busycraftsman/ats3b1/README.md

# ats3b1 project

# AT Sprint 3B.1
AT Sprint 3B1. 6 Bands HF CW/Digital Transceiver, designed by kd1jv.

# AT Sprint 3b.1 filter
filter board
