busycraftsman/ats3b1/嘉立创/drill.png

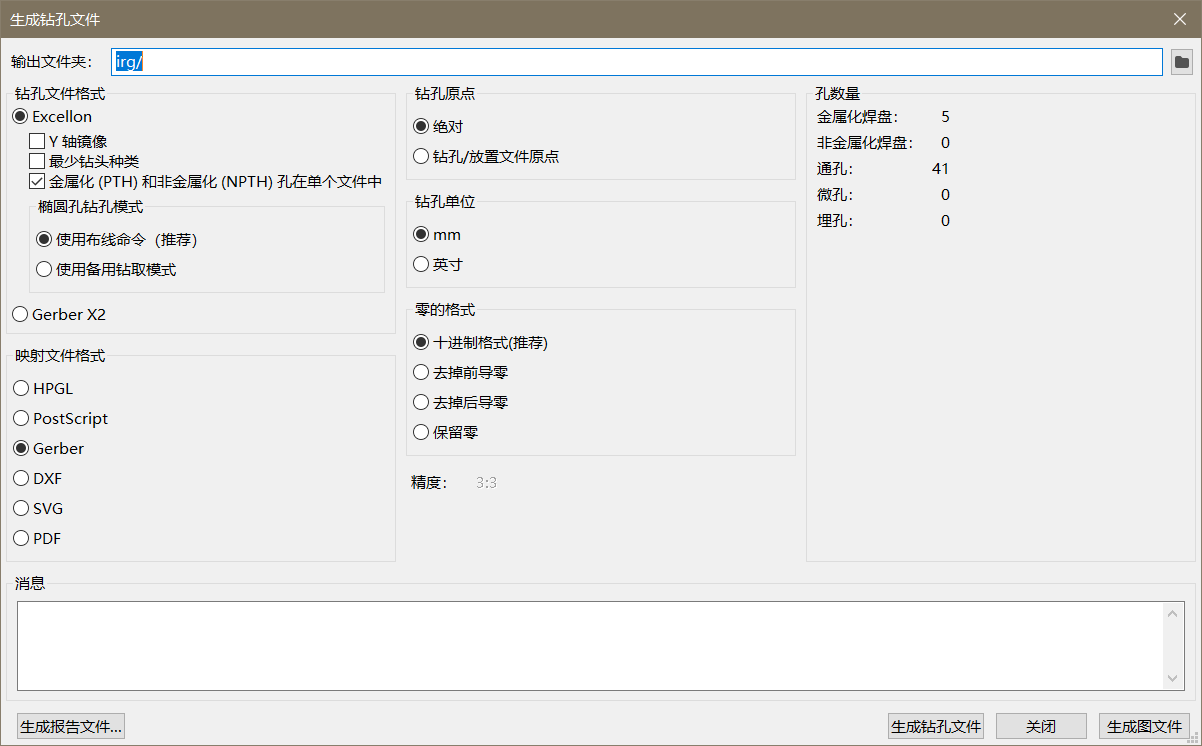
嘉立创/drill.png
