busycraftsman/ats3b1/嘉立创/plot.png

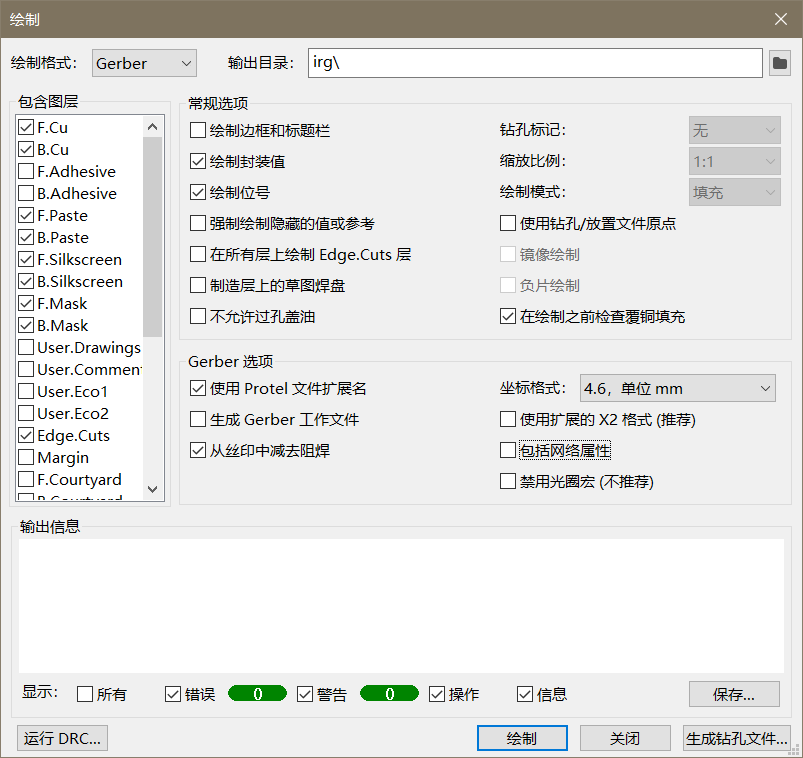
嘉立创/plot.png
