busycraftsman/ats3b1/AT Sprint 3B.1/bom/checklist.xlsx

R1 | 470ohm | C1 | 22p | U1 | SA612A | Q1 | NDT2955 | D1 | SS13(S2) | X1 | 4.9152Mhz |  |  | SW1 | CT1 | 30p | J1
R2 | 10k | C2 | 0.01uF | U2 | SA612A | Q2 | 2N7002 | D2 | BAV99 | X2 | 4.9152Mhz |  |  | SW2
R3 | 330k | C3 | 0.01uF | U3 | LM4808 | Q3 | 2N7002 | D3 | 1N4756 | X3 | 4.9152Mhz | L3 | FT37-43, 13T | SW3
R4 | 10k | C4 | 100p | U4 | CC5R | Q4 | BS170 | D4 | W8 | X4 | 4.9152Mhz |  |  | SW4
R5 | 330k | C5 | 100p | U5 | AC-AN6123MS | Q5 | BS170 |  |  | X5 | 4.9152Mhz
R6 | 22k | C6 | 100p | U6 | M430F1232 | Q6 | BS170 |  |  | X6 | 32.768k | L6 | 10uH
R7 | 22k | C7 | 100p | U7 | AD9834 |  |  |  |  |  |  |  |  |  |  |  |  | Power jack
R8 | 113k | C8 | 100p | U8 | AC02 |  |  |  |  |  |  |  |  |  |  |  |  | SMT phone jacks
R9 | 2.74k | C9 | 0.01uF | U9 | C3E(812C50) |  |  |  |  |  |  |  |  |  |  |  |  | Band module SIP header jack
R10 | 267k | C10 | 0.01uF | U10 | C2P(812C35)
R11 | 100k | C11 | 100p | U11 | MCP120-3151
R12 | 330k | C12 | 100p
R13 | 22k | C13 | 0.001uF
R14 | 100k | C14 | 0.001uF
R15 | 3.6k | C15 | 0.1uF
R16 | 270ohm | C16 | 0.1uF
R17 | 270ohm | C17 | 470p
R18 | 270ohm | C18 | 0.1uF
R19 | 100k | C19 | 0.1uF
R20 | 51ohm | C20 | 0.01uF
R21 | 10k | C21 | 0.01uF
R22 | 2.2k | C22 | 0.01uF
R23 | 10k | C23 | 0.01uF
R24 | 22k | C24 | 0.01uF
R25 | 100k | C25 | 0.1uF
R26 | 13.7k | C26 | 0.01uF
R27 | 47k | C27 | 0.01uF
R28 | 47k | C28 | 22p
R29 | 47k | C29 | 22p
R30 | 47k | C30 | 0.0p
R31 | 47k | C31 | 47p
R32 | 47k | C32 | 0.0p
R33 | 47k | C33 | 22p
R34 | 470ohm | C34 | 100p
R35 | 470ohm | C35 | 0.01uF
R36 | 470ohm | C36 | 0.1uF
R37 | 470ohm | C37 | 0.01uF
R38 | 470ohm | C38 | 0.01uF
R39 | 470ohm | C39 | 0.1uF
R40 | 470ohm | C40 | 0.1uF
R41 | 470ohm | C41 | 0.01uF
R42 | 22k | C42 | 0.01uF
 |  | C43 | 0.01uF
 |  | C44 | 0.01uF
 |  | C45 | 0.01uF
 |  | C46 | 0.1uF
 |  | C47 | 0.1uF
 |  | C48 | 0.01uF
 |  | C49 | 0.001uF
 |  | C50 | 0.01uF
 |  | C51 | 0.01uF
 |  | C52 | 0.1uF
 |  | C53 | 10uF/16V
 |  | C54 | 22uF/16V
 |  | C55 | 10uF/16V
 |  | C56 | 47uF/16V
 |  | C57 | 22uF/16V
 |  | C58 | 100uF, Alum
 |  | C59 | 0.1uF, Mono
