busycraftsman/ats3b1/AT Sprint 3B.1/schematic/board.pdf

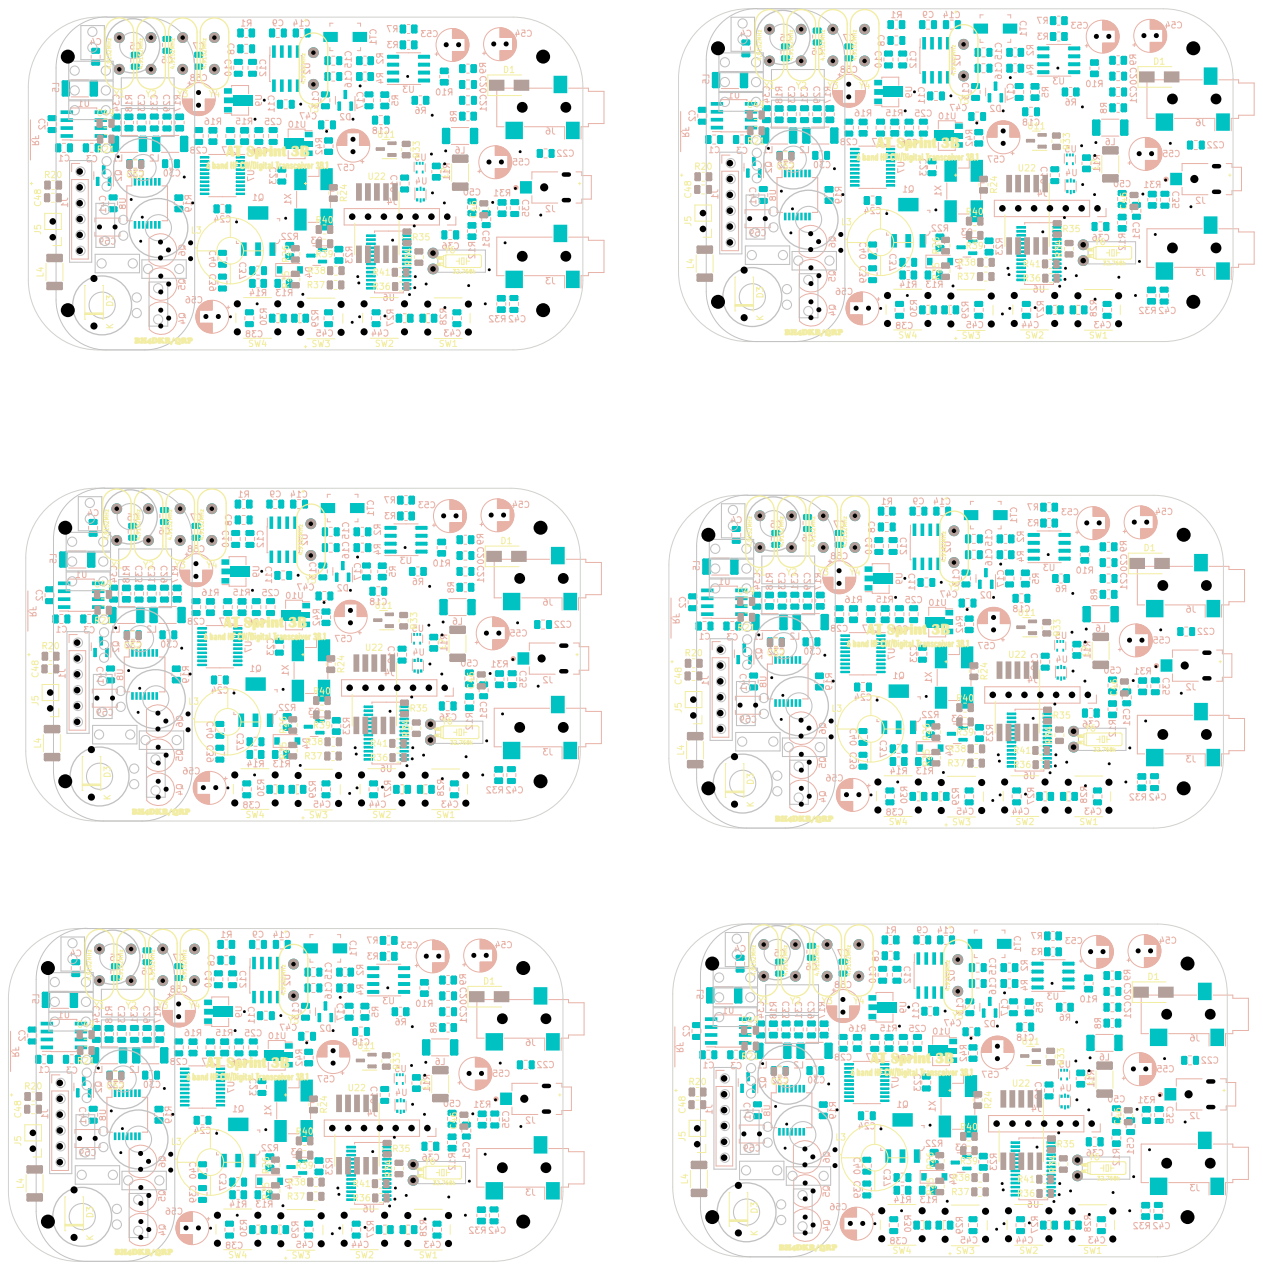
[picture p21: page 1]
