busycraftsman/ats3b1/AT Sprint 3B.1/AT Sprint 3B.1.kicad_pcb

## KiCad design AT Sprint 3B.1/AT Sprint 3B.1.kicad_pcb (2022-05-23)

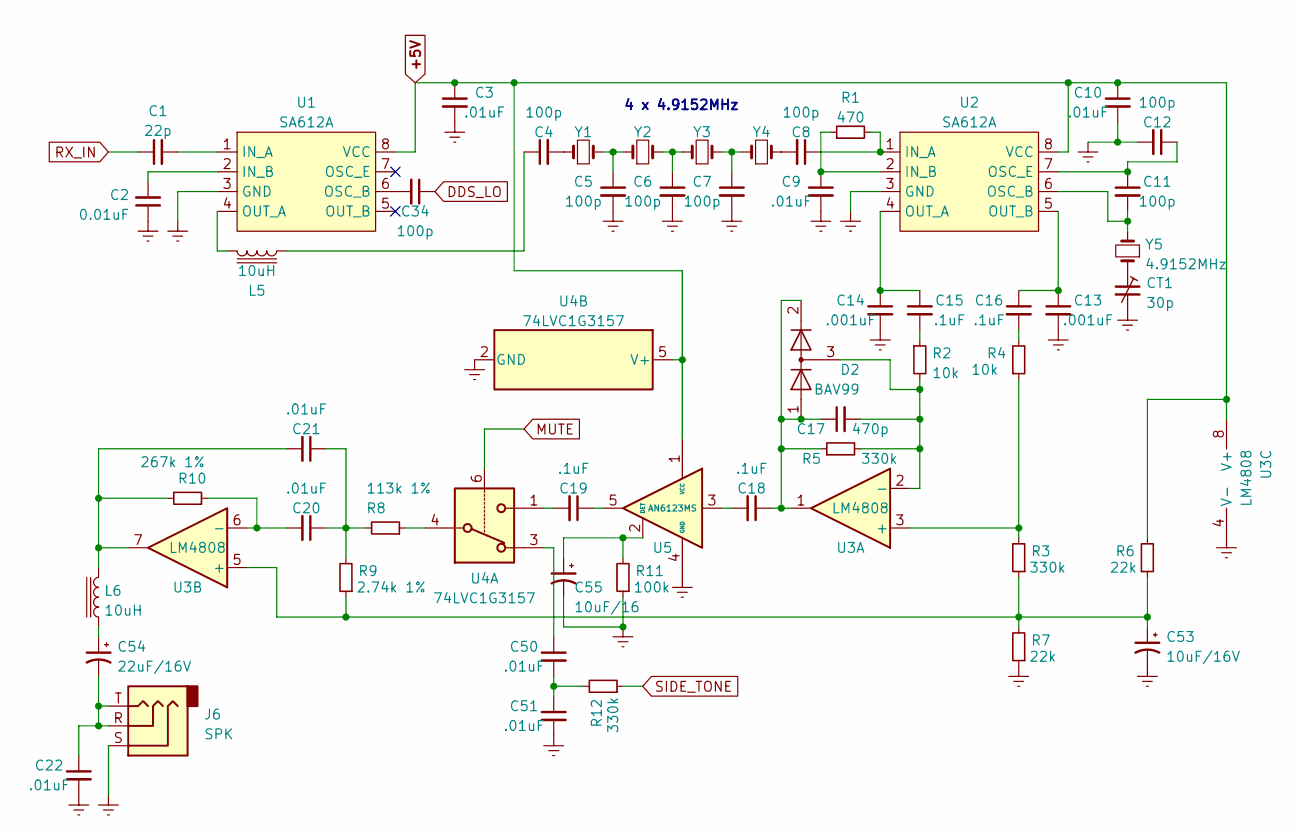
[picture p22: schematic ATS3B1-RECEIVER-AUDIO.kicad_sch]

Parts:
C1: 22p; C_0805_2012Metric
C2: 0.01uF; C_0805_2012Metric
C3, C9, C10, C20, C21, C22, C50, C51: .01uF; C_0805_2012Metric
C4, C5, C6, C7, C8, C11, C12, C34: 100p; C_0805_2012Metric
C13, C14: .001uF; C_0805_2012Metric
C15, C16, C18, C19: .1uF; C_0805_2012Metric
C17: 470p; C_0805_2012Metric
C53: 10uF/16V; CP_Radial_D5.0mm_P2.00mm
C54: 22uF/16V; CP_Radial_D5.0mm_P2.00mm
C55: 10uF/16; CP_Radial_D5.0mm_P2.00mm
CT1: 30p; C_TRIMMER_TZ03
D2: BAV99; SOT-23
J6: SPK; Jack_3.5mm_CUI_SJ-3523-SMT_Horizontal
L5, L6: 10uH; L_2010_5025Metric
R1: 470; R_0805_2012Metric
R2, R4: 10k; R_0805_2012Metric
R3, R5, R12: 330k; R_0805_2012Metric
R6, R7: 22k; R_0805_2012Metric
R8: 113k 1%; R_0805_2012Metric
R9: 2.74k 1%; R_0805_2012Metric
R10: 267k 1%; R_0805_2012Metric
R11: 100k; R_0805_2012Metric
U1, U2: SA612A; PowerIntegrations_SO-8
U3: LM4808; SOIC-8_3.9x4.9mm_P1.27mm
U4: 74LVC1G3157; SOT-666
U5: AN6123MS; SOT-553
Y1, Y2, Y3, Y4, Y5: 4.9152MHz; HC49US

Connections:
+5V: C3.1, C10.1, R6.2, U1.8 (VCC), U2.8 (VCC), U3.8 (V+), U4.5 (V+), U5.1 (VCC); also elsewhere on the board
DDS_LO: C34.1; also elsewhere on the board
GNDREF: C2.1, C3.2, C5.2, C6.2, C7.2, C9.2, C10.2, C12.2, C13.2, C14.2, C22.2, C51.2, C53.2, C55.2, CT1.2, J6.S, R7.1, R11.1, U1.3 (GND), U2.3 (GND), U3.4 (V-), U4.2 (GND), U5.4 (GND); also elsewhere on the board
MUTE: U4.6; also elsewhere on the board
unnamed: C1.2, U1.1 (IN_A)
unnamed: C2.2, U1.2 (IN_B)
unnamed: C4.1, L5.1
unnamed: C4.2, Y1.1
unnamed: C5.1, Y1.2, Y2.1
unnamed: C6.1, Y2.2, Y3.1
unnamed: C7.1, Y3.2, Y4.1
unnamed: C8.1, R1.2, U2.1 (IN_A)
unnamed: C8.2, Y4.2
unnamed: C9.1, R1.1, U2.2 (IN_B)
unnamed: C11.1, C12.1, U2.7 (OSC_E)
unnamed: C11.2, U2.6 (OSC_B), Y5.2
unnamed: C13.1, C16.1, U2.5 (OUT_B)
unnamed: C14.1, C15.1, U2.4 (OUT_A)
unnamed: C15.2, R2.1
unnamed: C16.2, R4.2
unnamed: C17.1, C18.1, D2.1 (K), D2.2 (A), R5.1, U3.1
unnamed: C17.2, D2.3 (K), R2.2, R5.2, U3.2 (-)
unnamed: C18.2, U5.3
unnamed: C19.1, U5.5
unnamed: C19.2, U4.1
unnamed: C20.1, C21.1, R8.2, R9.2
unnamed: C20.2, R10.1, U3.6 (-)
unnamed: C21.2, L6.2, R10.2, U3.7
unnamed: C22.1, C54.2, J6.R, J6.T
unnamed: C34.2, U1.6 (OSC_B)
unnamed: C50.1, U4.3
unnamed: C50.2, C51.1, R12.2
unnamed: C53.1, R3.1, R6.1, R7.2, R9.1, U3.5 (+)
unnamed: C54.1, L6.1
unnamed: C55.1, R11.2, U5.2 (DET)
unnamed: CT1.1, Y5.1
unnamed: L5.2, U1.4 (OUT_A)
unnamed: R3.2, R4.1, U3.3 (+)
unnamed: R8.1, U4.4
RX_IN: C1.1; also elsewhere on the board
SIDE_TONE: R12.1; also elsewhere on the board

Notes on the sheet:
4 x 4.9152MHz

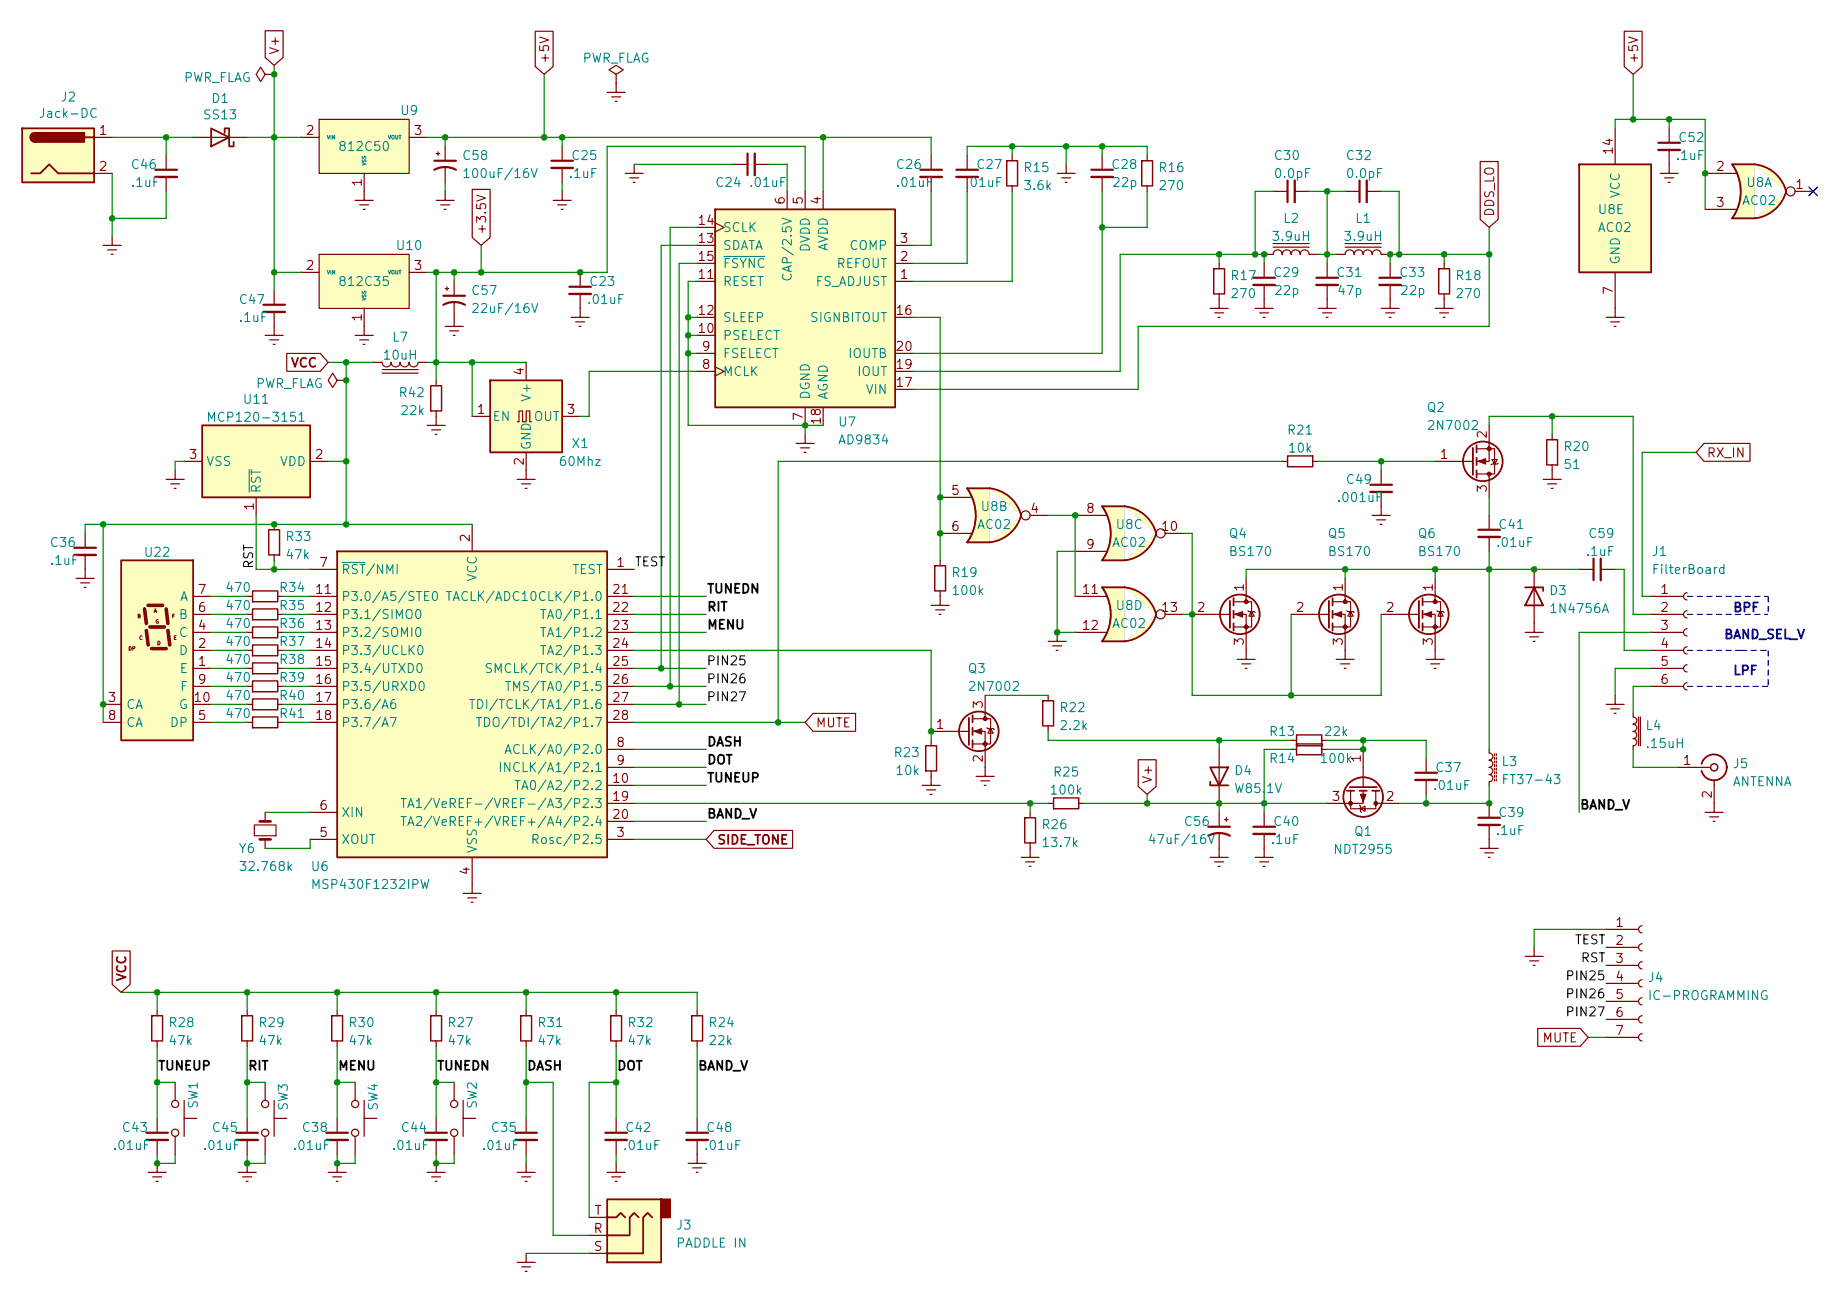
[picture p23: schematic ATS3B1-MCU-DDS-TX.kicad_sch]

Parts:
C23, C24, C26, C27, C35, C37, C38, C41, C42, C43, C44, C45, C48: .01uF; C_0805_2012Metric
C25, C36, C39, C40, C46, C47, C52: .1uF; C_0805_2012Metric
C28, C29, C33: 22p; C_0805_2012Metric
C30, C32: 0.0pF; C_0805_2012Metric
C31: 47p; C_0805_2012Metric
C49: .001uF; C_0805_2012Metric
C56: 47uF/16V; CP_Radial_D5.0mm_P2.00mm
C57: 22uF/16V; CP_Radial_D5.0mm_P2.00mm
C58: 100uF/16V; CP_Radial_D5.0mm_P2.00mm
C59: .1uF; C_Disc_D3.8mm_W2.6mm_P2.50mm
D1: SS13; D_SMA
D3: 1N4756A; D_DO-41_SOD81_P7.62mm_Horizontal
D4: W85.1V; D_SOD-123
J1: FilterBoard; PinSocket_1x06_P2.54mm_Vertical
J2: Jack-DC; CUI_PJ-041-SMT-TR
J3: PADDLE IN; Jack_3.5mm_CUI_SJ-3523-SMT_Horizontal
J4: IC-PROGRAMMING; PinHeader_1x07_P2.54mm_Vertical
J5: ANTENNA; PinHeader_1x02_P2.54mm_Vertical
L1, L2: 3.9uH; L_2010_5025Metric
L3: FT37-43; Choke_Toroid_horizontal_Diameter10-5mm_Amidon-FT37
L4: .15uH; L_2010_5025Metric
L7: 10uH; L_2010_5025Metric
Q1: NDT2955; Trans_SOT-223-4
Q2, Q3: 2N7002; SOT-23
Q4, Q5, Q6: BS170; TO-92
R13, R24, R42: 22k; R_0805_2012Metric
R14, R19, R25: 100k; R_0805_2012Metric
R15: 3.6k; R_0805_2012Metric
R16, R17, R18: 270; R_0805_2012Metric
R20: 51; R_0805_2012Metric
R21, R23: 10k; R_0805_2012Metric
R22: 2.2k; R_0805_2012Metric
R26: 13.7k; R_0805_2012Metric
R27, R28, R29, R30, R31, R32, R33: 47k; R_0805_2012Metric
R34, R35, R36, R37, R38, R39, R40, R41: 470; R_0805_2012Metric
SW1, SW2, SW3, SW4: SW_Push; SW_PUSH_6mm
U6: MSP430F1232IPW; TSSOP-28_4.4x9.7mm_P0.65mm
U7: AD9834; TSSOP-20_4.4x6.5mm_P0.65mm
U8: AC02; SSOP-14_5.3x6.2mm_P0.65mm
U9: 812C50; SOT-89-3
U10: 812C35; SOT-89-3
U11: MCP120-3151; SOT-23
U22: KCSA02-107; KCSC02-105
X1: 60Mhz; Oscillator_SMD_EuroQuartz_XO91-4Pin_7.0x5.0mm_HandSoldering
Y6: 32.768k; CRYSTAL-PTH-2X6-CYL

Connections:
+3.5V: C23.1, C57.1, L7.1, R42.2, U7.5 (DVDD), U10.3 (VOUT), X1.1 (EN), X1.4 (V+)
+5V: C25.1, C26.1, C52.1, C58.1, U7.4 (AVDD), U8.2, U8.3, U8.14 (VCC), U9.3 (VOUT); also elsewhere on the board
/ATS3B1-MCU-DDS-TX/BAND_V: C48.1, J1.3, R24.2, U6.20 (TA2/VeREF+/VREF+/A4/P2.4)
/ATS3B1-MCU-DDS-TX/DASH: C35.1, J3.R, R31.2, U6.8 (ACLK/A0/P2.0)
/ATS3B1-MCU-DDS-TX/DOT: C42.1, J3.T, R32.2, U6.9 (INCLK/A1/P2.1)
/ATS3B1-MCU-DDS-TX/MENU: C38.1, R30.2, SW4.2, U6.23 (TA1/P1.2)
/ATS3B1-MCU-DDS-TX/PIN25: J4.4, U6.25 (SMCLK/TCK/P1.4), U7.13 (SDATA)
/ATS3B1-MCU-DDS-TX/PIN26: J4.5, U6.26 (TMS/TA0/P1.5), U7.14 (SCLK)
/ATS3B1-MCU-DDS-TX/PIN27: J4.6, U6.27 (TDI/TCLK/TA1/P1.6), U7.15 (~FSYNC)
/ATS3B1-MCU-DDS-TX/RIT: C45.1, R29.2, SW3.2, U6.22 (TA0/P1.1)
/ATS3B1-MCU-DDS-TX/RST: J4.3, R33.1, U6.7 (~RST/NMI), U11.1 (~RST)
/ATS3B1-MCU-DDS-TX/TEST: J4.2, U6.1 (TEST)
/ATS3B1-MCU-DDS-TX/TUNEDN: C44.1, R27.2, SW2.2, U6.21 (TACLK/ADC10CLK/P1.0)
/ATS3B1-MCU-DDS-TX/TUNEUP: C43.1, R28.2, SW1.2, U6.10 (TA0/A2/P2.2)
DDS_LO: C32.2, C33.1, L1.2, R18.1, U7.17 (VIN); also elsewhere on the board
GNDREF: C23.2, C24.1, C25.2, C27.1, C28.1, C29.2, C31.2, C33.2, C35.2, C36.2, C38.2, C39.2, C40.2, C42.2, C43.2, C44.2, C45.2, C46.2, C47.2, C48.2, C49.2, C52.2, C56.2, C57.2, C58.2, D3.2 (A), J1.5, J2.2, J3.S, J4.1, J5.2 (Ext), Q3.2 (S), Q4.3 (S), Q5.3 (S), Q6.3 (S), R15.1, R16.1, R17.2, R18.2, R19.2, R20.1, R23.1, R26.2, R42.1, SW1.1, SW2.1, SW3.1, SW4.1, U6.4 (VSS), U7.7 (DGND), U7.9 (FSELECT), U7.10 (PSELECT), U7.11 (RESET), U7.12 (SLEEP), U7.18 (AGND), U8.7 (GND), U8.9, U8.12, U9.1 (VSS), U10.1 (VSS), U11.3 (VSS), X1.2 (GND); also elsewhere on the board
MUTE: J4.7, R21.2, U6.28 (TDO/TDI/TA2/P1.7); also elsewhere on the board
unnamed: C24.2, U7.6 (CAP/2.5V)
unnamed: C26.2, U7.3 (COMP)
unnamed: C27.2, U7.2 (REFOUT)
unnamed: C28.2, R16.2, U7.20 (IOUTB)
unnamed: C29.1, C30.1, L2.1, R17.1, U7.19 (IOUT)
unnamed: C30.2, C31.1, C32.1, L1.1, L2.2
unnamed: C37.1, Q1.1 (G), R13.2, R14.2
unnamed: C37.2, C39.1, L3.2, Q1.2 (D)
unnamed: C41.1, Q2.3 (D)
unnamed: C41.2, C59.1, D3.1 (K), L3.1, Q4.1 (D), Q5.1 (D), Q6.1 (D)
unnamed: C46.1, D1.2 (A), J2.1
unnamed: C49.1, Q2.1 (G), R21.1
unnamed: C59.2, J1.4
unnamed: D4.2 (A), R13.1, R22.2
unnamed: J1.2, Q2.2 (S), R20.2
unnamed: J1.6, L4.1
unnamed: J5.1 (In), L4.2
unnamed: Q3.1 (G), R23.2, U6.24 (TA2/P1.3)
unnamed: Q3.3 (D), R22.1
unnamed: Q4.2 (G), Q5.2 (G), Q6.2 (G), U8.10, U8.13
unnamed: R15.2, U7.1 (FS_ADJUST)
unnamed: R19.1, U7.16 (SIGNBITOUT), U8.5, U8.6
unnamed: R25.1, R26.1, U6.19 (TA1/VeREF-/VREF-/A3/P2.3)
unnamed: R34.1, U22.7 (A)
unnamed: R34.2, U6.11 (P3.0/A5/STE0)
unnamed: R35.1, U22.6 (B)
unnamed: R35.2, U6.12 (P3.1/SIMO0)
unnamed: R36.1, U22.4 (C)
unnamed: R36.2, U6.13 (P3.2/SOMI0)
unnamed: R37.1, U22.2 (D)
unnamed: R37.2, U6.14 (P3.3/UCLK0)
unnamed: R38.1, U22.1 (E)
unnamed: R38.2, U6.15 (P3.4/UTXD0)
unnamed: R39.1, U22.9 (F)
unnamed: R39.2, U6.16 (P3.5/URXD0)
unnamed: R40.1, U22.10 (G)
unnamed: R40.2, U6.17 (P3.6/A6)
unnamed: R41.1, U22.5 (DP)
unnamed: R41.2, U6.18 (P3.7/A7)
unnamed: U6.5 (XOUT), Y6.1
unnamed: U6.6 (XIN), Y6.2
unnamed: U7.8 (MCLK), X1.3 (OUT)
unnamed: U8.4, U8.8, U8.11
RX_IN: J1.1; also elsewhere on the board
SIDE_TONE: U6.3 (Rosc/P2.5); also elsewhere on the board
V+: C40.1, C47.1, C56.1, D1.1 (K), D4.1 (K), Q1.3 (S), R14.1, R25.2, U9.2 (VIN), U10.2 (VIN)
VCC: C36.1, L7.2, R24.1, R27.1, R28.1, R29.1, R30.1, R31.1, R32.1, R33.2, U6.2 (VCC), U11.2 (VDD), U22.3 (CA), U22.8 (CA)

Notes on the sheet:
BAND_SEL_V
LPF
BPF

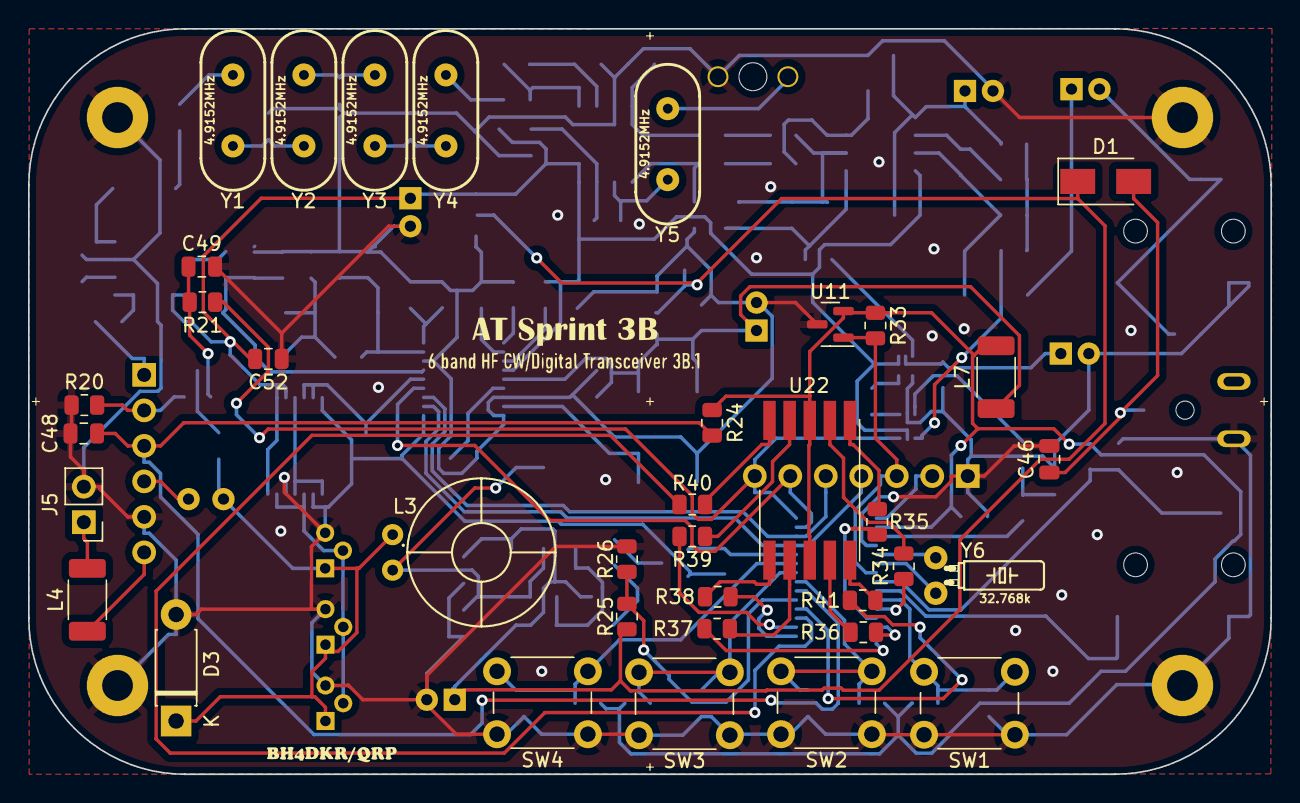
[picture p24: board AT Sprint 3B.1.kicad_pcb from above]

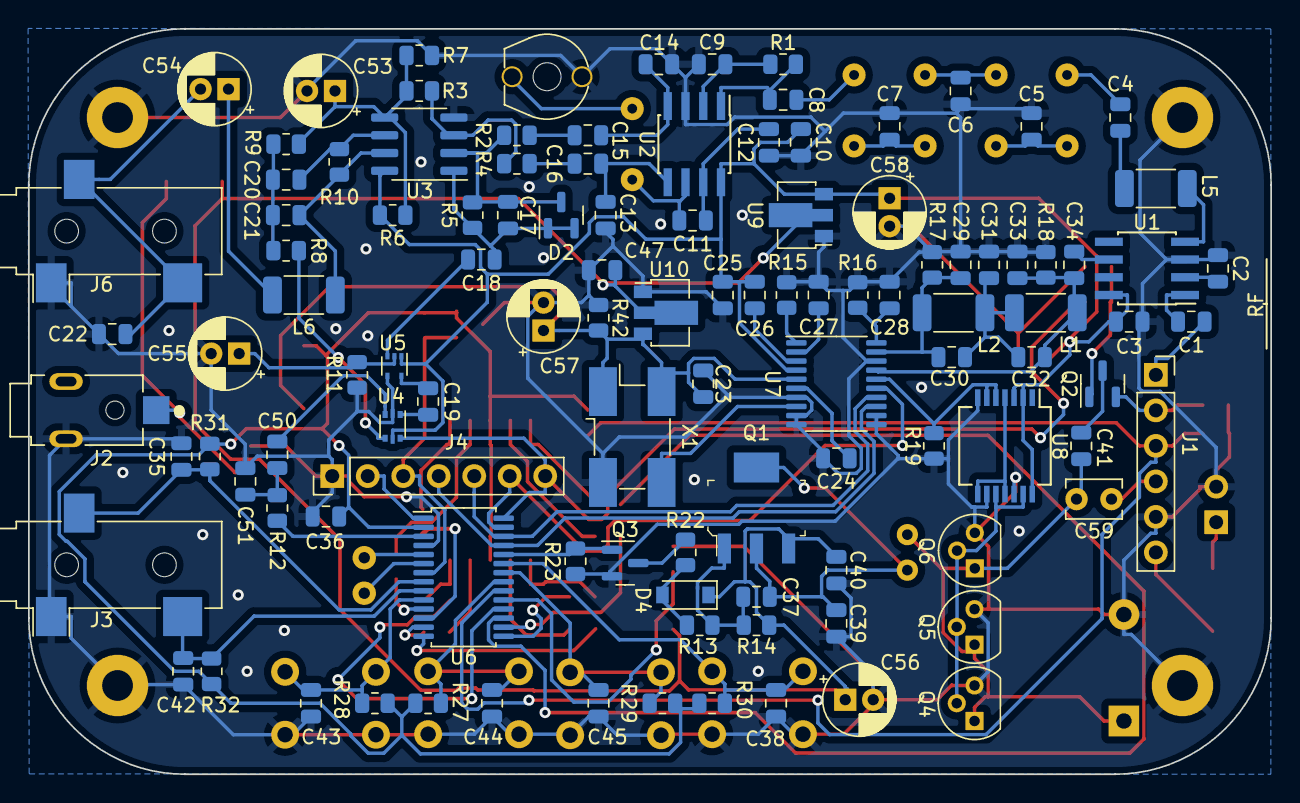
[picture p25: board AT Sprint 3B.1.kicad_pcb from below]

Board: 2 copper layers, 88.9 x 53.3 mm, 148 parts (112 on the bottom side), 99 nets.
