busycraftsman/ats3b1/AT Sprint 3B.1 filter/AT Sprint 3B.1 filter.kicad_pcb

## KiCad design AT Sprint 3B.1 filter/AT Sprint 3B.1 filter.kicad_pcb (2022-05-23)

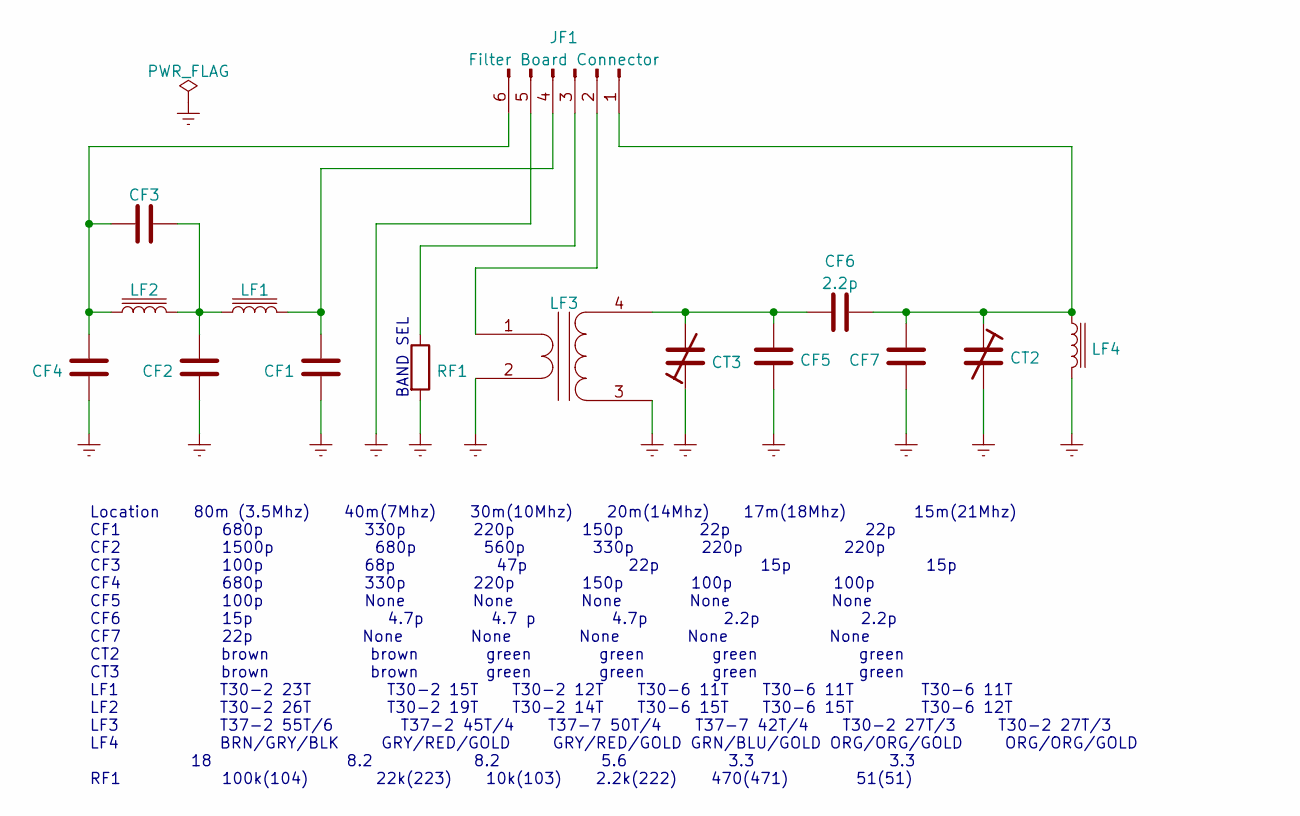
[picture p26: schematic AT Sprint 3B.1 filter.kicad_sch, AT Sprint 3B.1 Filter Board]

Parts:
CF1, CF2, CF3, CF4, CF5, CF7: C; C_Disc_D5.0mm_W2.5mm_P5.00mm
CF6: 2.2p; C_Disc_D5.0mm_W2.5mm_P5.00mm
CT2, CT3: C_Trim; C_TRIMMER_TZ03
JF1: Filter Board Connector; PinHeader_1x06_P2.54mm_Vertical
LF1, LF2: L_Iron; Toroid_horizontal_T37
LF3: Transformer_1P_1S_1vsN; Toroid_transformer_horizontal_T37
LF4: L_Iron; L_Axial_L7.0mm_D3.3mm_P2.54mm_Vertical_Fastron_MICC
RF1: R; R_0805_2012Metric_Pad1.20x1.40mm_HandSolder

Connections:
GNDREF: CF1.2, CF2.2, CF4.1, CF5.2, CF7.1, CT2.2, CT3.1, JF1.5, LF3.2 (AB), LF3.3 (SA), LF4.2, RF1.2
unnamed: CF1.1, JF1.4, LF1.2
unnamed: CF2.1, CF3.2, LF1.1, LF2.2
unnamed: CF3.1, CF4.2, JF1.6, LF2.1
unnamed: CF5.1, CF6.1, CT3.2, LF3.4 (SB)
unnamed: CF6.2, CF7.2, CT2.1, JF1.1, LF4.1
unnamed: JF1.2, LF3.1 (AA)
unnamed: JF1.3, RF1.1

Notes on the sheet:
BAND SEL
Location 80m (3.5Mhz) 40m(7Mhz) 30m(10Mhz) 20m(14Mhz) 17m(18Mhz) 15m(21Mhz) CF1 680p 330p 220p 150p 22p 22p CF2 1500p 680p 560p 330p 220p 220p CF3 100p 68p 47p 22p 15p 15p CF4 680p 330p 220p 150p 100p 100p CF5 100p None None None None None CF6 15p 4.7p 4.7 p 4.7p 2.2p 2.2p CF7 22p None None None No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

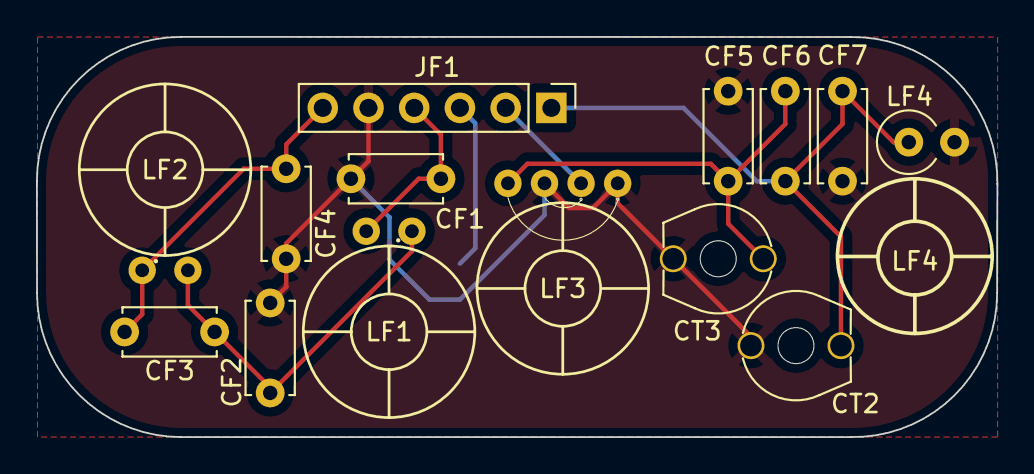
[picture p27: board AT Sprint 3B.1 filter.kicad_pcb from above]

Board: 2 copper layers, 53.4 x 22.2 mm, 15 parts (1 on the bottom side), 8 nets.
