busycraftsman/ats3b1/(commit log)

2022-05-20 add first version
    [AT Sprint 3B.1 filter.kicad_pcb, AT Sprint 3B.1 filter.kicad_sch, AT Sprint 3B.1.kicad_pcb, AT Sprint 3B.1.kicad_sch, AT Sprint 3B.1.sch, ATS3B1-MCU-DDS-TX.kicad_sch, ATS3B1-RECEIVER-AUDIO.kicad_sch, ATS3B1filter.dsn]
2022-05-20 remove freeroute interchange files
    [ATS3B1filter.dsn]
2022-05-21 add filter boundary in User.Drawing layer, fit room for filter board
    [AT Sprint 3B.1 filter.kicad_pcb, AT Sprint 3B.1.kicad_pcb, ATS4B.kicad_pcb, ATS4B.kicad_sch]
2022-05-21 generate ats3b1 filter gerb file
    [AT Sprint 3B.1 filter-B_Cu.gbl, AT Sprint 3B.1 filter-B_Mask.gbs, AT Sprint 3B.1 filter-B_Paste.gbp, AT Sprint 3B.1 filter-B_Silkscreen.gbo, AT Sprint 3B.1 filter-Edge_Cuts.gm1, AT Sprint 3B.1 filter-F_Cu.gtl, AT Sprint 3B.1 filter-F_Mask.gts, AT Sprint 3B.1 filter-F_Paste.gtp]
2022-05-21 change text size for production
    [AT Sprint 3B.1 filter-B_Cu.gbl, AT Sprint 3B.1 filter-B_Mask.gbs, AT Sprint 3B.1 filter-B_Paste.gbp, AT Sprint 3B.1 filter-B_Silkscreen.gbo, AT Sprint 3B.1 filter-Edge_Cuts.gm1, AT Sprint 3B.1 filter-F_Cu.gtl, AT Sprint 3B.1 filter-F_Mask.gts, AT Sprint 3B.1 filter-F_Paste.gtp]
2022-05-21 fix C11 footprint
    [AT Sprint 3B.1 filter-B_Cu.gbl, AT Sprint 3B.1 filter-B_Mask.gbs, AT Sprint 3B.1 filter-B_Paste.gbp, AT Sprint 3B.1 filter-B_Silkscreen.gbo, AT Sprint 3B.1 filter-Edge_Cuts.gm1, AT Sprint 3B.1 filter-F_Cu.gtl, AT Sprint 3B.1 filter-F_Mask.gts, AT Sprint 3B.1 filter-F_Paste.gtp]
2022-05-21 fix C22 TRS connection error
    [AT Sprint 3B.1.kicad_pcb, AT Sprint 3B.1.kicad_sch, ATS3B1-RECEIVER-AUDIO.kicad_sch]
2022-05-23 fix some errors. release for pcb production
    [AT Sprint 3B.1-B_Cu.gbl, AT Sprint 3B.1-B_Mask.gbs, AT Sprint 3B.1-B_Paste.gbp, AT Sprint 3B.1-B_Silkscreen.gbo, AT Sprint 3B.1-Edge_Cuts.gm1, AT Sprint 3B.1-F_Cu.gtl, AT Sprint 3B.1-F_Mask.gts, AT Sprint 3B.1-F_Paste.gtp]
